AbilitySpectrum/Sensact/Enclosures/v4.2/Sensact v42 enclosure v1.3.stl

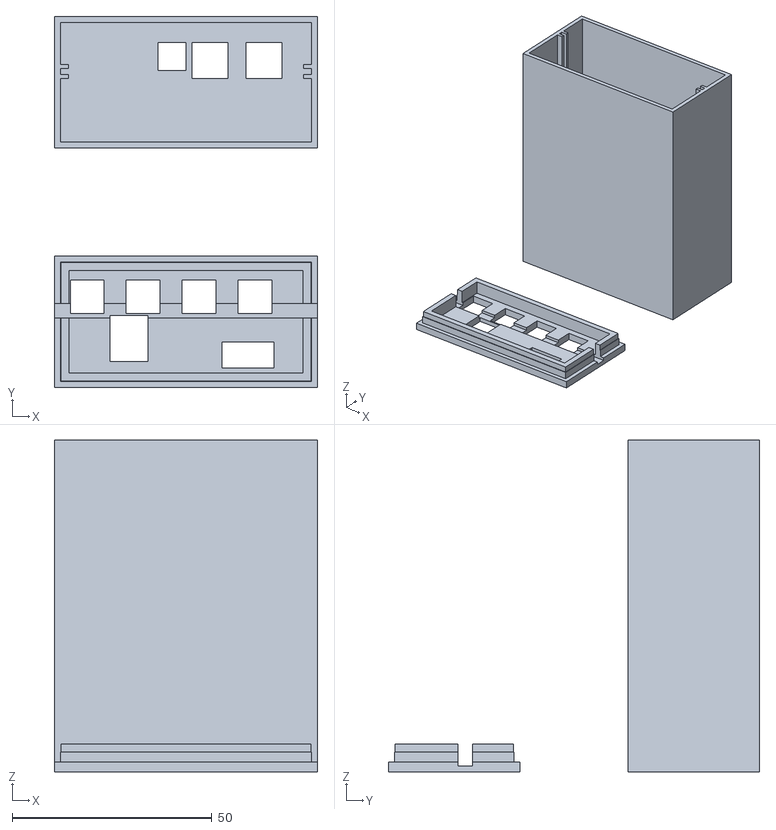
[picture p48: CAD file, 2018-05-30]
Enclosures/v4.2/Sensact v42 enclosure v1.3.stl
66.0 x 93.0 x 83.2
