AbilitySpectrum/Sensact/Arduino/Lib Instructions.txt

The Arduino code requires a version IRLib2 to compile and run.

We are using a version of IRLib2 by Chris Young - Version 2.0.16 May 3, 2018

To use this library: 
. Place the IRLib2-master.zip file in a separate directory
. Unzip the file
. Follow the installation instructions in the 'readme.md' file
