AbilitySpectrum/Sensact/Documents/ISAAC_2016_material/Roll_up_collage_low-1.pdf

# SENSACT

# The Applications

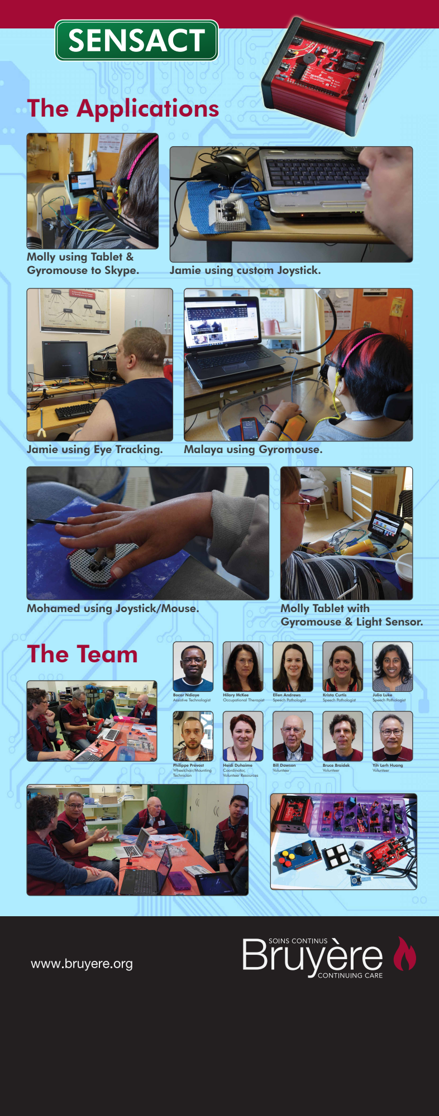
[picture p49: page 1]
The Team; Jamie using Eye Tracking.; Malaya using Gyromouse.; Mohamed using Joystick/Mouse.; Molly Tablet with; Bocar Ndiaye Assistive Technologist; Julia Luke Speech Pathologist; Heidi Duhaime Coordinator, Volunteer Resources; Bruce Braidek Volunteer; Bill Dawson Volunteer; Krista Curtis Speech Pathologist; Philippe Prévost Wheelchair/Mounting Technician; Hilary McKee Occupational Therapist; Ellen Andrews Speech Pathologist

Molly using Tablet &
Gyromouse to Skype.

Jamie using custom Joystick.

Gyromouse & Light Sensor.

Yih Lerh Huang
Volunteer
