AbilitySpectrum/Sensact/Documents/ISAAC_2016_material/SENSACT_FUNCTIONS_72x45-1.pdf

USER NEEDS | ACCESS METHODS | PROCESSOR | COMMUNICATION DEVICES

# SENSACT FUNCTIONS

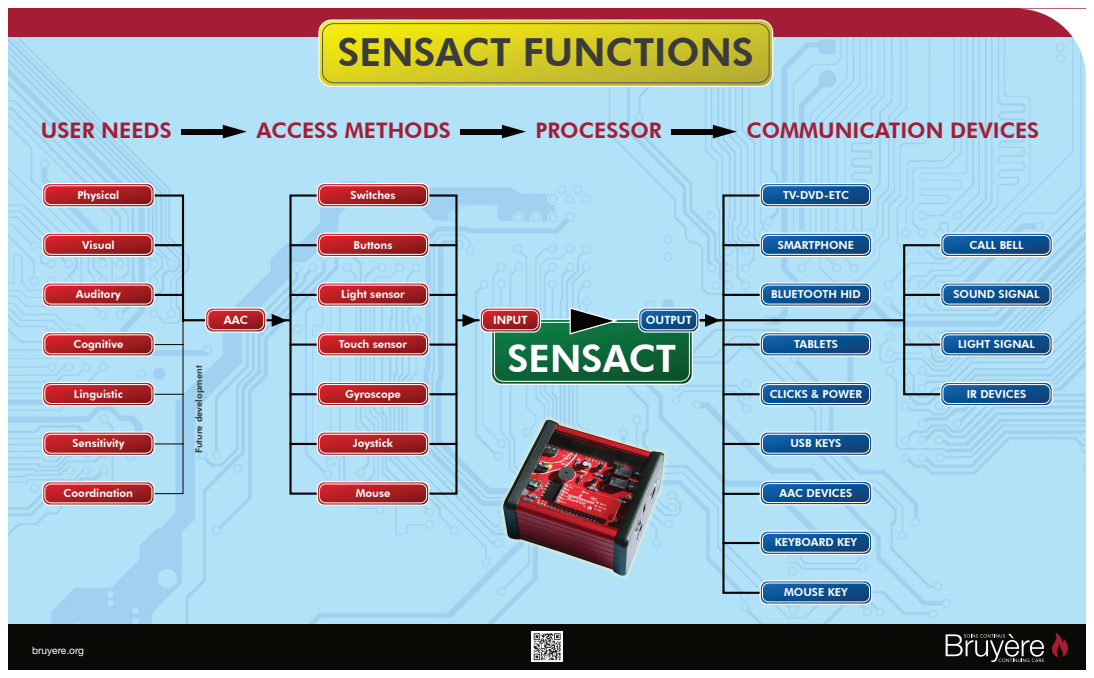
[picture p50: page 1]
bruyere.org; SENSACT; Physical; Visual; Auditory; Cognitive; Linguistic; Sensitivity; Coordination; Future development; Switches; Buttons; Light sensor; Touch sensor; Gyroscope; Joystick; Mouse; AAC; INPUT; OUTPUT; SMARTPHONE; BLUETOOTH HID; TABLETS; CLICKS & POWER; USB KEYS; AAC DEVICES; KEYBOARD KEY; MOUSE KEY; CALL BELL; SOUND SIGNAL; LIGHT SIGNAL; IR DEVICES

TV-DVD-ETC
