AbilitySpectrum/Sensact/Documents/ISAAC_2016_material/SENSACT_HARDWARE_72x36-1.pdf

## INPUT

## OUTPUT

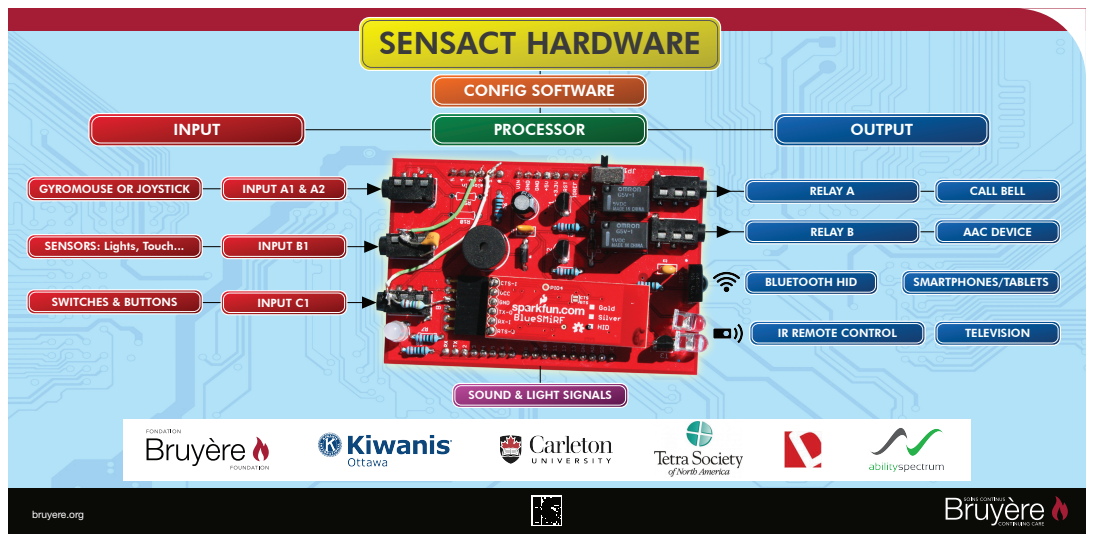
[picture p51: page 1]
bruyere.org; GYROMOUSE OR JOYSTICK; INPUT A1 & A2; RELAY A; CALL BELL; RELAY B; AAC DEVICE; IR REMOTE CONTROL; TELEVISION; SENSORS: Lights, Touch...; INPUT B1; SWITCHES & BUTTONS; INPUT C1; BLUETOOTH HID; SENSACT HARDWARE; PROCESSOR; CONFIG SOFTWARE; SMARTPHONES/TABLETS

SOUND & LIGHT SIGNALS
