AbilitySpectrum/Sensact/Board/v4.2/Schematic.pdf

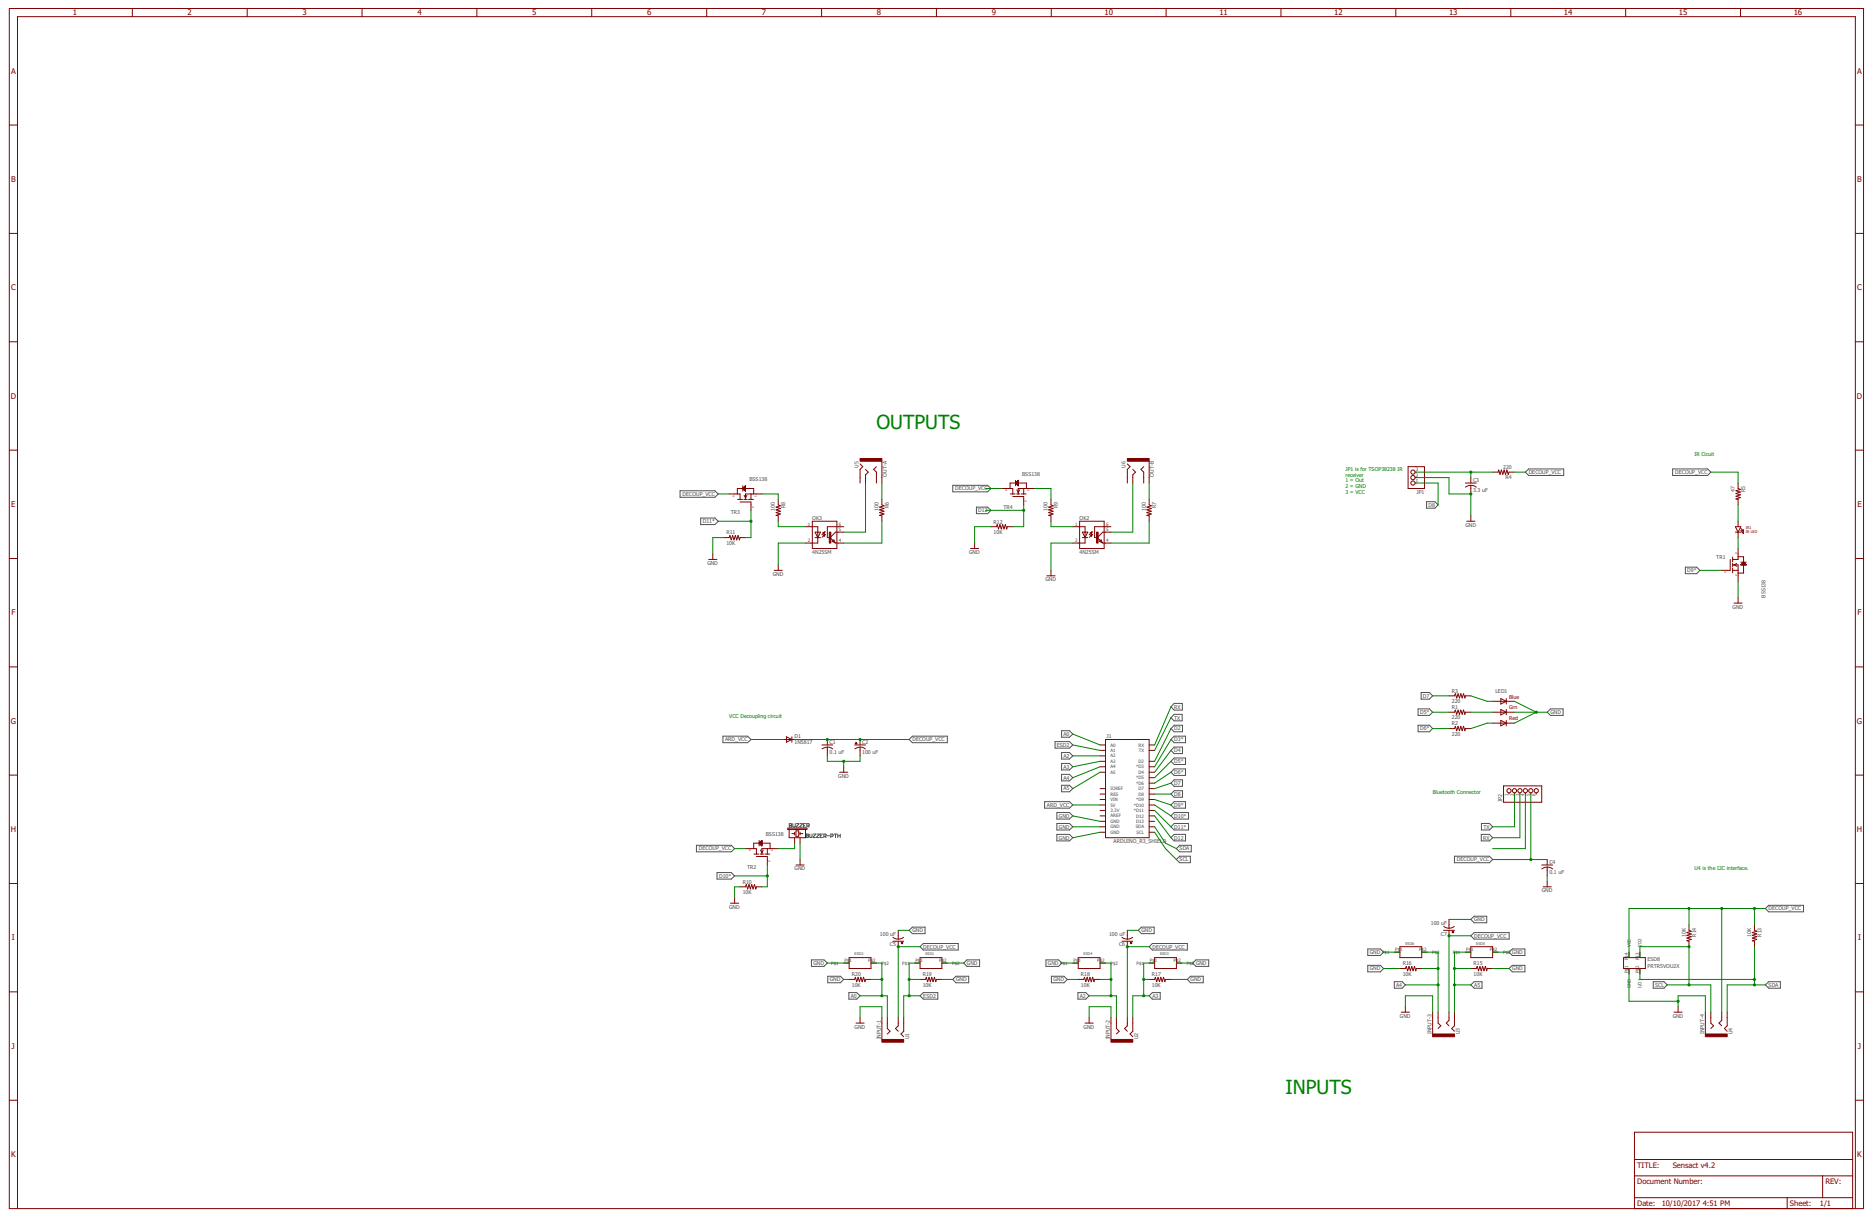
[picture p52: page 1]
