AbilitySpectrum/Sensact/Board/v4.2/4.2-Bottom.pdf

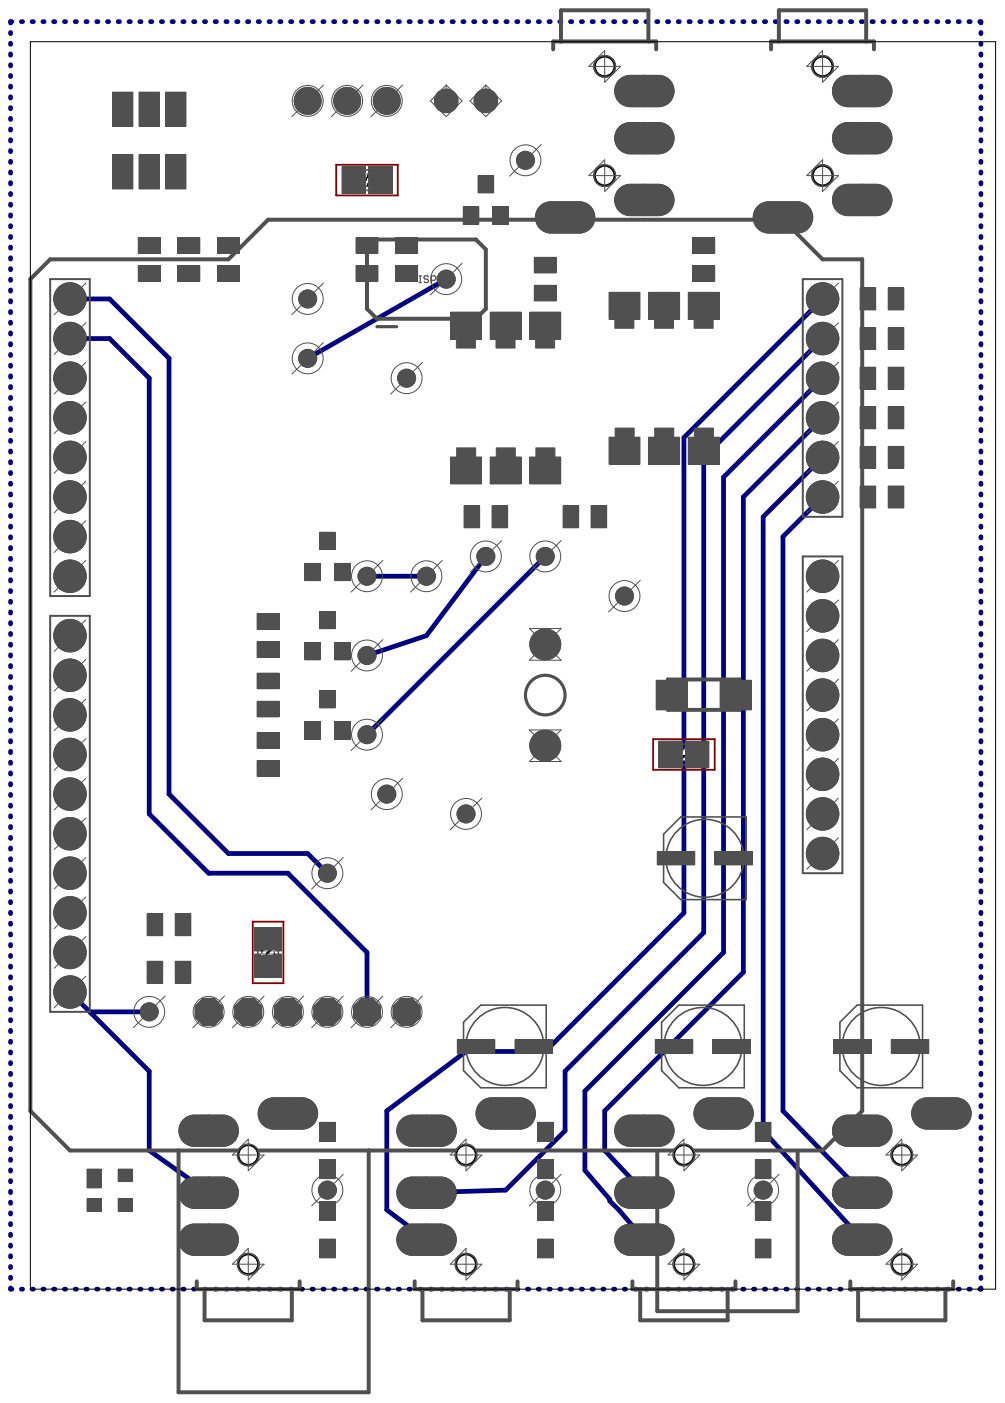
[picture p53: page 1]
