AbilitySpectrum/Sensact/Board/v4.2/4.2-Top.pdf

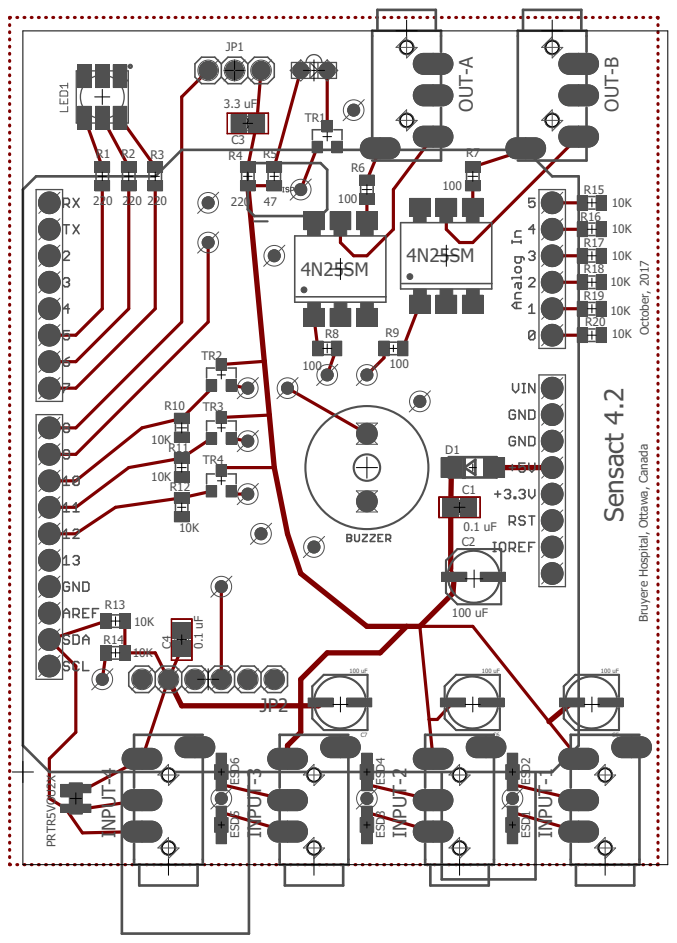
[picture p54: page 1]

Bruyere Hospital, Ottawa, Canada October, 2017
