AbilitySpectrum/Sensact/Board/v4.2/Sensact v4.2.brd

## EAGLE design Board/v4.2/Sensact v4.2.brd (2018-04-08)

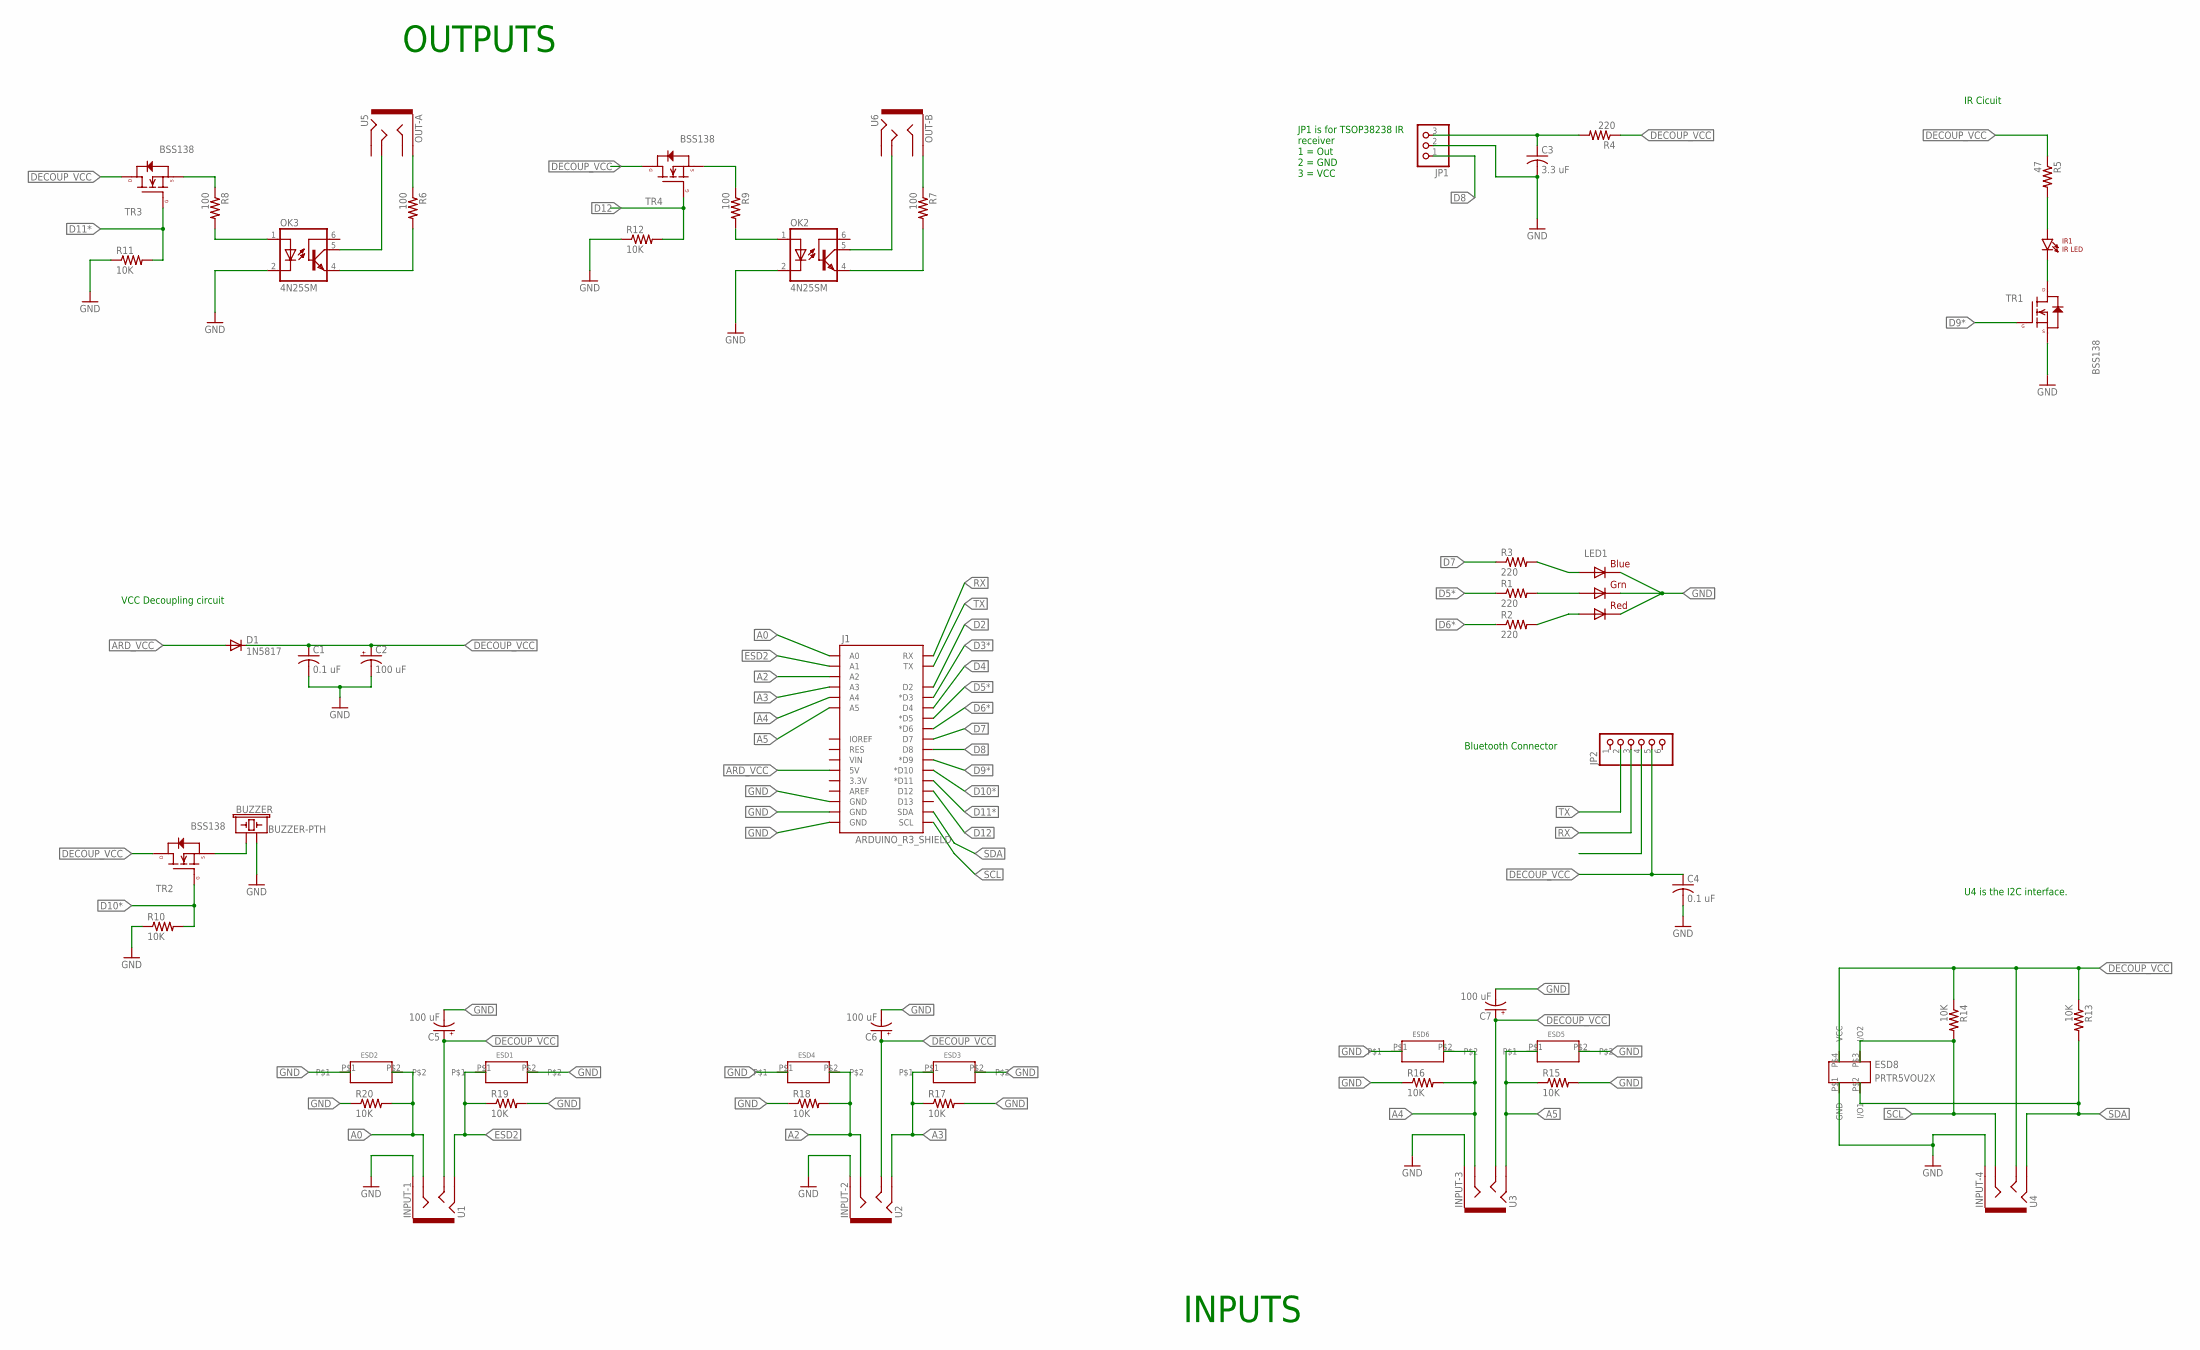
[picture p55: schematic Sensact v4.2.sch]

Parts:
BUZZER: BUZZER-PTH; BUZZER-12MM
C1, C4: 0.1 uF; C0805
C2, C5, C6, C7: 100 uF; PANASONIC_C
C3: 3.3 uF; C0805
D1: 1N5817; DO214AC
ESD1, ESD2, ESD3, ESD4, ESD5, ESD6: PESD5V0S1BA; SOD323
ESD8: PRTR5VOU2X; 215
INPUT-1: U1; AUDIO-JACK-TRRS-THRUHOLE
INPUT-2: U2; AUDIO-JACK-TRRS-THRUHOLE
INPUT-3: U3; AUDIO-JACK-TRRS-THRUHOLE
INPUT-4: U4; AUDIO-JACK-TRRS-THRUHOLE
IR1: IR LED; LTE-302
J1: ARDUINO_R3_SHIELD; UNO_R3_SHIELD
JP1: PINHD-1X3; 1X03
JP2: PINHD-1X6; 1X06
LED1: RGBLED5050
OK2, OK3: 4N25SM; DIL6-SMD
OUT-A: U5; AUDIO-JACK-TRRS-THRUHOLE
OUT-B: U6; AUDIO-JACK-TRRS-THRUHOLE
R1, R2, R3, R4: 220; 0805
R5: 47; 0805
R6, R7, R8, R9: 100; 0805
R10, R11, R12, R13, R14, R15, R16, R17, R18, R19, R20: 10K; 0805
TR1, TR2, TR3, TR4: BSS138; SOT23-3

Connections:
A0: ESD2.P$2, INPUT-1.RING1, J1.A0, R20.2
A2: ESD4.P$2, INPUT-2.RING1, J1.A2, R18.2
A3: ESD3.P$1, INPUT-2.RING2, J1.A3, R17.1
A4: ESD6.P$2, INPUT-3.RING1, J1.A4, R16.2
A5: ESD5.P$1, INPUT-3.RING2, J1.A5, R15.1
ARD_VCC: D1.A, J1.5V
D2: J1.D2
D3*: J1.D3 (*D3)
D4: J1.D4
D5*: J1.D5 (*D5), R1.1
D6*: J1.D6 (*D6), R2.1
D7: J1.D7, R3.1
D8: J1.D8, JP1.1
D9*: J1.D9 (*D9), TR1.1 (G)
D10*: J1.D10 (*D10), R10.2, TR2.1 (G)
D11*: J1.D11 (*D11), R11.2, TR3.1 (G)
D12: J1.D12, R12.2, TR4.1 (G)
DECOUP_VCC: C1.1, C2.+, C4.1, C5.+, C6.+, C7.+, D1.C, ESD8.P$4 (VCC), INPUT-1.TIP, INPUT-2.TIP, INPUT-3.TIP, INPUT-4.TIP, JP2.5, R4.1, R5.1, R13.1, R14.1, TR2.3 (D), TR3.3 (D), TR4.3 (D)
ESD2: ESD1.P$1, INPUT-1.RING2, J1.A1, R19.1
GND: BUZZER.- (2), C1.2, C2.-, C3.2, C4.2, ESD1.P$2, ESD2.P$1, ESD3.P$2, ESD4.P$1, ESD5.P$2, ESD6.P$1, ESD8.P$1 (GND), INPUT-1.SLEEVE (EARTH), INPUT-2.SLEEVE (EARTH), INPUT-3.SLEEVE (EARTH), INPUT-4.SLEEVE (EARTH), J1.GND@0 (GND), J1.GND@1 (GND), J1.GND@2 (GND), JP1.2, JP2.4, LED1.4 (BLUE_C), LED1.5 (RED_C), LED1.6 (GREEN_C), OK2.2 (C), OK3.2 (C), R10.1, R11.1, R12.1, R15.2, R16.1, R17.2, R18.1, R19.2, R20.1, TR1.2 (S)
unnamed: C3.1, JP1.3, R4.2
unnamed: OK3.4 (EMI), R6.2
unnamed: OK2.1 (A), R9.2
unnamed: OK3.1 (A), R8.2
unnamed: LED1.3 (BLUE_A), R3.2
unnamed: LED1.1 (GREEN_A), R1.2
unnamed: LED1.2 (RED_A), R2.2
unnamed: OK3.5 (COL), OUT-A.TIP
unnamed: OUT-A.SLEEVE (EARTH), R6.1
unnamed: OK2.5 (COL), OUT-B.TIP
unnamed: OUT-B.SLEEVE (EARTH), R7.1
unnamed: OK2.4 (EMI), R7.2
unnamed: IR1.A, R5.2
unnamed: IR1.C, TR1.3 (D)
unnamed: BUZZER.+ (1), TR2.2 (S)
unnamed: R9.1, TR4.2 (S)
unnamed: R8.1, TR3.2 (S)
RX: J1.RX, JP2.3
SCL: ESD8.P$3 (I/O2), INPUT-4.RING1, J1.SCL, R14.2
SDA: ESD8.P$2 (I/O1), INPUT-4.RING2, J1.SDA, R13.2
TX: J1.TX, JP2.2

Notes on the sheet:
JP1 is for TSOP38238 IR receiver 1 = Out 2 = GND 3 = VCC
VCC Decoupling circuit
U4 is the I2C interface.
OUTPUTS
INPUTS
Bluetooth Connector
IR Cicuit

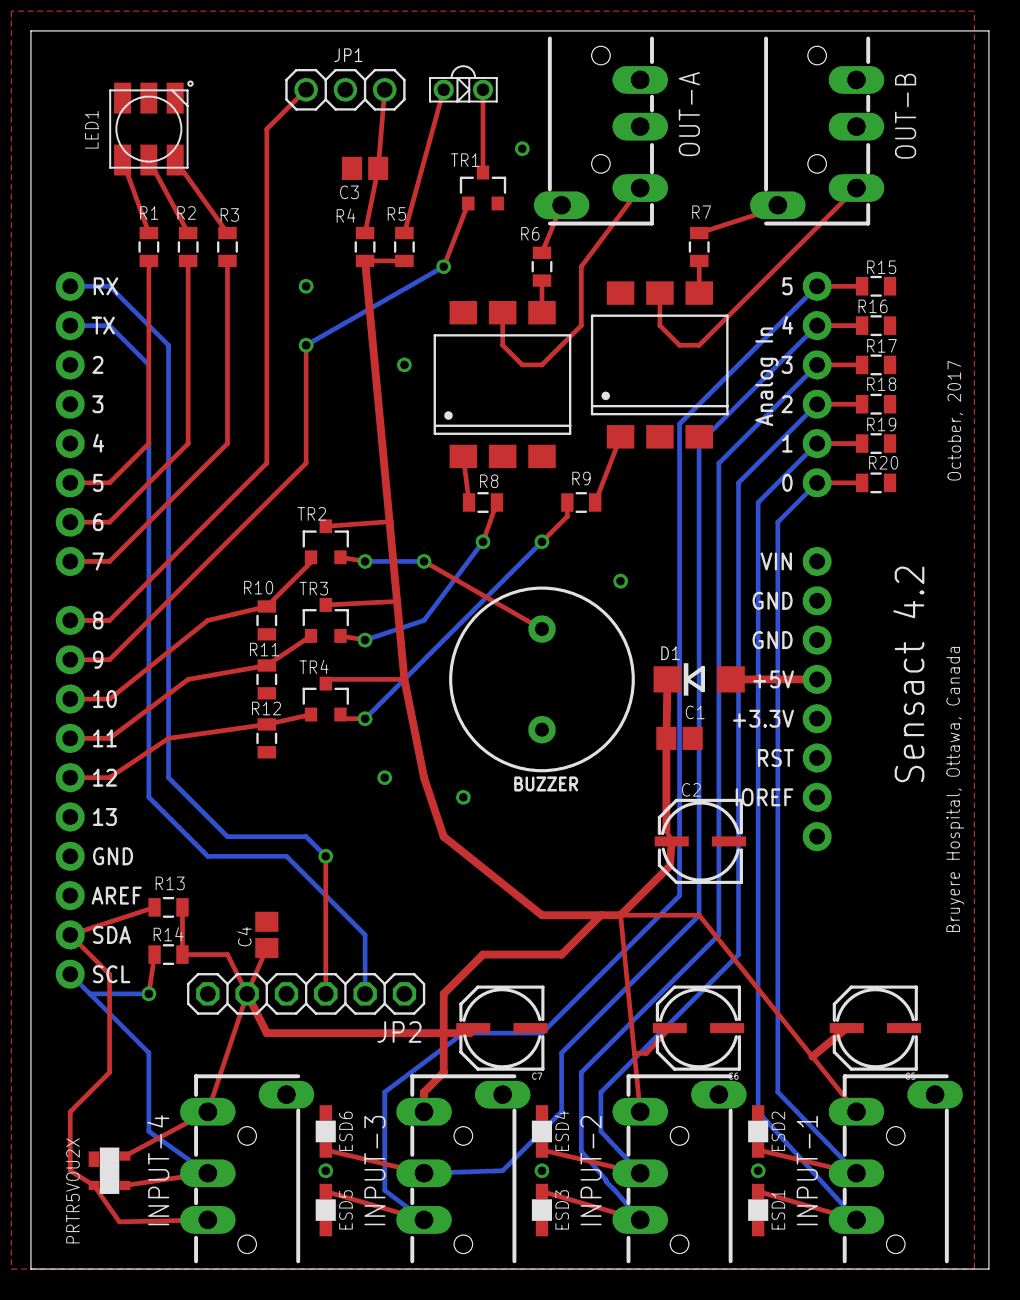
[picture p56: board Sensact v4.2.brd from above]

Board: 2 copper layers, 61.9 x 80.0 mm, 53 parts (0 on the bottom side), 38 nets.
