AbilitySpectrum/Sensact/Related_Projects/other/geninput/geninput.ino

#include <Mouse.h>
#include <Keyboard.h>

/*********************************************************
   2016-06-11 Sat : ylh

   I added reading from digital as well as analog lines and send the readings
   out to serial port (can be commented out in #define SERIAL_OUT

   digital signals are sent as -0, -1, etc
   analog signals are sent as "YPR:?:?:?"
   The touchpad signals are sent out as +0, +1, ..., +11

   These conventions are compatible with the p5 browser app:  ~/0/gendisplay

   HID mouse control is controlled from the Joystick's A0, A1 signals,
   click = digital pin 3 (LEFT) pin 2 (RIGHT)

   --- touch pad code comes from
   This is a library for the MPR121 12-channel Capacitive touch sensor

   Designed specifically to work with the MPR121 Breakout in the Adafruit shop
   ----> https://www.adafruit.com/products/

   These sensors use I2C communicate, at least 2 pins are required
   to interface

   Adafruit invests time and resources providing this open source code,
   please support Adafruit and open-source hardware by purchasing
   products from Adafruit!

   Written by Limor Fried/Ladyada for Adafruit Industries.
   BSD license, all text above must be included in any redistribution
 **********************************************************/
/*** HOW TO USE
   #define SERIAL_OUTPUT to output input signals. Do not use with mouse.
   #define SEE_ANALOG to output the analog pins
   #define SEE_DIGITAL to output the digital lines
   #define SEE_TOUCHPAD to output touchpad (I2C) data
   #define USE_MOUSE use mouse control - must turn off SERIAL_OUTPUT
*/
#define SERIAL_OUTPUT
#define SEE_ANALOG
#define SEE_DIGITAL
#define SEE_TOUCHPAD
//#define USE_MOUSE
//#define SEE_TOUCHPAD
//#define SPECIAL_MELANIE

const uint32_t CHECK_INTERVAL = 20;
const uint32_t REFRACTORY = 400;
uint32_t l_checked;

#include <Wire.h>
#include "Adafruit_MPR121.h"

// MPR touchpad
// You can have up to 4 on one i2c bus but one is enough for testing!
Adafruit_MPR121 cap = Adafruit_MPR121();
// output "+?" where ? is the key number

// Keeps track of the last pins touched
// so we know when buttons are 'released'
uint16_t lasttouched = 0;
uint16_t currtouched = 0;

// analogPins
const int nAnalogPins = 3;
int analogPins[nAnalogPins] = {
  A0, A1, A2
};

// digitalPins
// when pushed, we output "-0", "-1", "-2", "-3"
const int nDigitalPins = 8; //14;
int digitalPins[nDigitalPins] = {
  // 0, 1, 2, 3, 4, 5, 6, 7, 8, 9, 10, 11, 12, 13
  // 3, 4, 5, 6
  6, 7, 8, 9, A2, A3, A4, 0   // Emartee joystick+4 keys AND Sparkfun 4 pads: Melanie
};

int toggleLeft = 0; // for Drag
int keyPressed = 0;

void setup() {

#ifdef SERIAL_OUTPUT
  while (!Serial);        // needed to keep leonardo/micro from starting too fast!
  Serial.begin(9600);
#endif

#ifdef SEE_TOUCHPAD
  touchSetup();
#endif

#ifdef SEE_DIGITAL
  digitalPinsSetup();
#endif

#ifdef SEE_ANALOG
  analogPinsSetup();
#endif

#ifdef USE_MOUSE
  mouseSetup();
#endif
}

void loop() {

  if ( l_checked < CHECK_INTERVAL || l_checked < REFRACTORY ) l_checked = millis();

  if ( millis() - l_checked < CHECK_INTERVAL ) return;
  if ( keyPressed == 1 && ( millis() - l_checked < REFRACTORY ) ) return;
  keyPressed = 0;

  l_checked = millis();

#ifdef SEE_TOUCHPAD
  touchLoop();
#endif

#ifdef SEE_DIGITAL
  digitalPinsLoop();
#endif

#ifdef SEE_ANALOG
  analogPinsLoop();
#endif

#ifdef USE_MOUSE
  mouseLoop();
#endif

}

void analogPinsSetup() {
}

void analogPinsLoop() {

#ifdef SERIAL_OUTPUT
  Serial.print("YPR"); // use the YPR meter!

  for ( int j = 0; j < nAnalogPins; j++ ) {
    Serial.print(":");
    Serial.print(map(analogRead(analogPins[j]), 0, 1023, -60, 60 ));
  }
  Serial.print("\n");
#endif
}

void digitalPinsSetup() {
  for ( int j = 0; j < nDigitalPins; j++ ) {
    pinMode( digitalPins[j], INPUT_PULLUP);
  }
}

void digitalPinsLoop() {

  for ( int j = 0; j < nDigitalPins; j++ ) {
    if ( digitalRead(digitalPins[j]) == LOW ) {

#ifdef SERIAL_OUTPUT
      Serial.print("-:");
      Serial.println(j);
#endif

#ifdef SPECIAL_MELANIE
     melanieDown(j);
#endif
    }
    else {
#ifdef SPECIAL_MELANIE
      melanieUp(j);
#endif

    }
  }
}

#ifdef SPECIAL_MELANIE
void melanieDown( int j) {
  keyPressed = 1;
  if ( j == 0 ) {
    Keyboard.press(KEY_PAGE_DOWN);
  }
  if ( j == 3 ) {
    Mouse.press(MOUSE_LEFT);
    toggleLeft = 0;
  }
  if ( j == 2 ) {
    Keyboard.press(KEY_PAGE_UP);
  }
  if ( j == 1 ) {
    Mouse.press(MOUSE_RIGHT);
  }
  if ( j == 4 ) {
    if ( toggleLeft == 0 ) {
      Mouse.press(MOUSE_LEFT);
    }
    else  {
      Mouse.release(MOUSE_LEFT);
    }
    toggleLeft = 1 - toggleLeft;
  }
  if ( j == 5 ) {
    Keyboard.press('L');
    Keyboard.release('L');
    Keyboard.press('O');
    Keyboard.press('L');
    Keyboard.press('!');
    Keyboard.press(KEY_RETURN);
    Keyboard.releaseAll();
  }
  if ( j == 6 ) {
    Keyboard.press(KEY_ESC);
  }
  if ( j == 7 ) {
    Keyboard.press(KEY_LEFT_ALT);
    Keyboard.press(KEY_TAB);
  }
}


void melanieUp(int j) {
  if ( j == 0 ) {
    Keyboard.release(KEY_PAGE_DOWN);
  }
  if ( j == 3 ) {
    if ( toggleLeft == 0 ) {  // release Left Click only when NOT being dragged
      Mouse.release(MOUSE_LEFT);
    }
  }
  if ( j == 2 ) {
    Keyboard.release(KEY_PAGE_UP);
  }
  if ( j == 1 ) {
    Mouse.release(MOUSE_RIGHT);
  }
  if ( j == 4 ) {

  }
  if ( j == 5 ) {

  }
  if ( j == 6 ) {
    Keyboard.release(KEY_ESC);
  }
  if ( j == 7 ) {
    Keyboard.release(KEY_LEFT_ALT);
    Keyboard.release(KEY_TAB);
  }
}
#endif

#ifdef SEE_TOUCHPAD
void touchSetup() {

#ifdef SERIAL_OUTPUT
  Serial.println("Adafruit MPR121 Capacitive Touch sensor test");
#endif
  // Default address is 0x5A, if tied to 3.3V its 0x5B
  // If tied to SDA its 0x5C and if SCL then 0x5D
  if (!cap.begin(0x5A)) {

#ifdef SERIAL_OUTPUT
    Serial.println("MPR121 not found, check wiring ? ");
#endif
    while (1);
  }

#ifdef SERIAL_OUTPUT
  Serial.println("MPR121 found!");
#endif
}

void touchLoop() {
  // Get the currently touched pads
  currtouched = cap.touched();

  /* VERSION 1
    for (uint8_t i = 0; i < 12; i++) {
    // it if *is* touched and *wasnt* touched before, alert!
    if ((currtouched & _BV(i)) && !(lasttouched & _BV(i)) ) {
    Serial.print(" + : "); Serial.println(i); //Serial.println(" touched");
    }
    // if it *was* touched and now *isnt*, alert!
    if (!(currtouched & _BV(i)) && (lasttouched & _BV(i)) ) {
    Serial.print(" - : "); Serial.println(i); //Serial.println(" released");
    }
    }
    //*/

  //* VERSION to work with p5.js ~/0/touchpad
  for (uint8_t i = 0; i < 12; i++) {
    if ((currtouched & _BV(i)) ) {

#ifdef SERIAL_OUTPUT
      Serial.print("+:");
      Serial.println(i);
#endif
    }
  }

  //*/

  /* VERSION to output somewhat graphically
    for (uint8_t i = 0; i < 12; i++) {
    if ((currtouched & _BV(i)) ) {
    Serial.print(i);
    } else Serial.print(" ");
    }
    Serial.println();
    //*/

  // reset our state
  lasttouched = currtouched;

  // comment out this line for detailed data from the sensor!
  return;

  // debugging info, what
  Serial.print("\t\t\t\t\t\t\t\t\t\t\t\t\t 0x");
  Serial.println(cap.touched(), HEX);
  Serial.print("Filt : ");
  for (uint8_t i = 0; i < 12; i++) {
    Serial.print(cap.filteredData(i));
    Serial.print("\t");
  }
  Serial.println();
  Serial.print("Base : ");
  for (uint8_t i = 0; i < 12; i++) {
    Serial.print(cap.baselineData(i));
    Serial.print("\t");
  }
  Serial.println();

  // put a delay so it isn't overwhelming
  delay(500);
}

#endif
