AbilitySpectrum/Sensact/(commit log)

2016-03-28 Baseline code
    the Arduino version works with v1 of the Sensact board with the Pro
    Micro board
2016-04-11 modes for Sensact v2
    - local p5 files
    - #ifdefs for the two versions
    - remove gyro capabilities for now
2016-04-13 update
    - commented out gyro code
2016-05-07 - change index.html -> configSensact.html - added REFRACTORY period after trigger - bug fix: RELAY_? -> SENSACT_OUT?
2016-05-30 Initial commit of board design files
    These are the board design files for the board produced in April 2016.
    The Gerber files were placed in a subdirectory for simplicity.
    [DRILEGEND.CFG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]
2016-05-31 Added .pdf files of board and schematic
    Added .pdf files for those who don't use/have Eagle
2016-06-06 added functional doc, altered sensact arduino send config package
2016-06-07 minor update
    for newer Arduino IDE, say 1.6.3, we need to comment out
    - Mouse.h
    - HID.h
    - Keyboard.h
2016-06-17 Test program to be used following assembly
    This program tests the following functions:
    Beeper, Bluetooth, LED, and switch connected to D7
2016-06-21 changed mouse control
    - geninput: changed mouse control to use initial values for ‘zero’
    - sensact: now include output box
2016-06-21 added MPR121 enclosure
    [7cmx12cmX5cm.stl]
2016-06-23 arduino code can do multiple triggers per sensor. Also, can differentiate a long and short click.
    [SensactArduinoCode.ino]
2016-06-30 New Arduino code can now do buzzer, bluetooth HID, relays, keboard, and mouse. It is ready to be tested
    [SensactArduinoCode.ino]
2016-06-30 geninput handles joystick + 8 buttons for M.
2016-07-18 reset relays
2016-07-26 updated sensact app to display sensors over threshold range slider
2016-07-26 xbee bluetooth works as sensor
2016-07-27 long and short click function, can set long click time
    [SensactArduinoCode.ino]
2016-07-28 reorganized folders
    [7cmx12cmX5cm.stl, DRILEGEND.CFG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]
2016-07-28 added Enclosures/v1 and Documents/ISAAC_2016
    [sensact_box (2).stl, sensact_box (3).stl]
2016-07-28 short and long click work
    [SensactArduinoCode.ino]
2016-08-04 Config: fixed invert, changed some gui labels, port display now scrolls. \nArduino: fixed bluetooth communication errors, added mouse speed macro
    [SensactArduinoCode.ino]
2016-08-04 added bluno beetle code for Gyro Mouse
2016-08-06 Arduino code for BT_HID Sensact
2016-11-14 Create Sensact v3.0 schematic.pdf
2016-11-14 v3 board schematic added incorrectly, fixing...
2016-11-14 Adding v3 schematic for comment
2016-11-23 Version 3 Arduino Code
    Complete working code for Arduino side of version 3.
2016-11-27 Handle negative sensor values
    This change allows 2-byte values (in particular sensor values) to be
    negative numbers. Values in triggers and in sensor reports can now be
    negative.
2016-11-27 More IO adjustments.
    Corrections for negative number handling. Also add blank to the set of
    chars ignored as white space.
    [IO.cpp, IO.h, Triggers.cpp]
2016-12-02 "Keyboard" cmd from PC - Arduino side
    This was Bill's suggestion. Make it possible for a user who can control
    a PC, to send commands to the Sensact.
2016-12-02 "Keyboard" cmd from PC - PC side
    These files define a new web page with buttons. The page also uses
    serial.js.
2016-12-02 Committing Eagle files for Sensact 3.0a
    Board layout, schematic, and accompanying .pdfs. Also included Gerber
    files.
    [DRILEGEND.CFG, Sensact v3.0 a_backup.brd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]
2016-12-02 Display char value for PC Keyboard sensor.
    Use the character value, rather than character code in the Keyboard
    trigger. This is much easier for those customizing the function, since
    character values have to match those in keybdcontrol.html
2016-12-04 Gyro Sensor
    First cut of a gyro sensor. Now have IR and Gyro both. Code size is
    22,608 of 28,672. Increase max number of triggers and actions. Free
    heap space is now 592 bytes.
2017-01-15 Arduino 1.6.12 support
    Changes to support latest arduino version.
2017-01-15 Make mouse-button typing faster.
    Make mouse move faster as repeat action is continued.
2017-01-15 Show active sensors.
    Underline the text of sensors that have associated triggers.
2017-01-15 Change ANY trigger action.
    Do not trigger the ANY state trigger if sensor is already in the action
    state.
2017-01-22 UI Adjustments
    invert check box replaces active high/low radio btns.
    underline sensors which have triggers
    remove unused 'createSensorSelector' code
2017-03-02 Added Mouse Nudge
    Support for Gyro mouse control.
2017-04-17 Reset trigger states after a reload.
    This provides a way to recover from inadvertently getting a trigger into
    an unused (or possibly unknown) state.
    [Triggers.cpp]
2017-04-20 Enhancements to test program.
    Repeated reading of pins.
    Gyro I2C support.
2017-04-21 IR Testing
    Added 't' option for IR circuit testing.
2017-04-21 LED Correction
    Handle reverse logic for LEDs
    [SensactArduinoCode.ino]
2017-04-22 Us Pull ups on analog inputs
    Us pull up resistors so unconnected inputs do not float. This was also
    needed to make TASH switch work.
2017-04-22 Safety Reset
    When new triggers are loaded reset all triggers, actions and sensors.
    Unfortunately this consumed a bit of memory space and the max # of
    triggers has had to be reduced to 18.
    [Actions.cpp, Actions.h, Sensact.h, SensactArduinoCode.ino, Sensors.cpp, Sensors.h, Triggers.cpp, Triggers.h]
2017-04-26 Latch Logic Fix
    A previous change to deal with reverse LED logic also had the effect of
    turning off power to all the inputs - OOPS!
    [SensactArduinoCode.ino]
2017-05-10 Memory Saving Trick #2
    Put sensorID and actionID in char instead of int. Savings: 23 bytes.
2017-05-11 Dual trigger setting feedback.
    Trigger setting flashes a light AND sound the buzzer. Handy when we
    have no light.
    [SensactArduinoCode.ino]
2017-05-28 Keyboard Control classes
    Make keyboard control class structure similar to Mouse control. Also,
    fix a timing bug in the general repeat-action code.
    [Actions.cpp, Actions.h]
2017-05-29 Increase relay pulse width.
    This makes the call bell work.
2017-06-21 LED color correction
    Get the LED colors to display correctly.
    [Sensact.h, SensactArduinoCode.ino]
2017-08-18 SetState action support
    Allows one sensor to alter the state of another.
2017-09-05 Eagle & Gerber Files
    [Sensact v4.1.brd, Sensact v4.1.sch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]
2017-09-14 Arduino code update for V4.1
    Basic operation has been confirmed. Detailed testing should still be
    done.
2017-09-27 Bug Fix - 'Set State' action items not destroyed.
    Set action to ‘Set State’ – Sensor drop down appears. Go to another
    action. Sensor drop down does not disappear!!
2017-10-26 Stop runaway mouse repeat actions.
    If sensor value has been near 0 for 15 seconds assume it is
    disconnected.
2017-10-27 Gyro init improvement
    Initialize Gyro when it is plugged in. It can now be connected or
    disconnected at any time.
2017-10-28 Improved runaway mouse fix.
    Sensors are assumed DISCONNECTED until a non-zero signal is detected.
    This means no runaway mouse at all on startup.
    [SensactArduinoCode.ino, Triggers.cpp, Triggers.h]
2017-10-29 Runaway mouse #3
    Allow for negative values too - e.g. from gyro.
2017-11-07 Port Selection Dialog
    Add a port selection dialog for systems that do not provide a device
    with the name "Leonardo"
2018-01-08 Detect any gyro motion
    Use the sqrt of the sum of the squares of X, Y and Z gyro motions to
    detect any motion.
2018-01-24 Initial work on ATMega support.
    Not fully tested yet. Big issue - does not work with Bluetooth!! I2C
    is OK. IR is untested.
    [Actions.cpp, Actions.h, SensactArduinoCode.ino, Sensors.cpp]
2018-03-03 Lightbox
    A new feedback mechanism for clients - a box with controllable lights.
    Uses an MCP23008 to control 8 lights via the I2C port. Adjustments made
    to MAX_ACTIONS to squeeze into memory.
2018-03-05 Various UI adjustments
    Also, made ActionName an ENUM rather than just a String. Allows for
    more robust error checking.
    [SetThresholdsDlg.java]
2018-03-28 I18N Model resources
    Isolate sensor and action related strings to a resource file.
2018-03-29 Clear All & Active Tab Markers
    Add markers to show tabs which contain triggers, and add a button to
    clear all triggers from all tabs.
2018-04-04 Relay Options
    Relay ON and OFF options added.
2018-04-08 V4.2 board design
    [Sensact v4.2.brd, Sensact v4.2.sch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]
2018-05-22 Change INPUT to SENSOR
2018-05-23 Enclosure for v1.3 for Board release v4.2
    [Sensact v42 enclosure v1.3.stl]
2018-05-29 Key shortcuts for Run and Idle
    [MainFrame.java]
2018-05-30 Solutions Changes
    Major additions to the solutions button.
2018-05-30 New tones on Save
    Now success is signalled by two high beeps.
    Failure by a low raspberry.
    [SensactArduinoCode.ino]
2018-05-31 Added Schematic.pdf
2018-09-13 Init adjustment
    Initialize Trigger sensor state array right at the start.
2018-10-25 Minor test improvement
    Added more tones to buzzer test.
    [SensActTesting.ino]
2018-10-28 License header added to Arduino code
2018-12-03 Arduino changes
2019-04-09 Fix for IR code failures
    [MainFrame.java]
2019-05-13 New Serial Feedback program.
    [config.txt]
2019-05-15 Cut and Paste for Sensact Config
2019-05-15 More options for SerialFeedback
    Configurable display time and title bar.
    [config.txt]
2019-06-02 LED Display Code
    Supports Don's LED screen as a means to provide visual feedback.
2019-06-03 Minor bug fix.
    Sensor levels were not being copied correctly. Error was introduced
    when implementing copy/paste.
2019-06-07 LED_Display changed to LCD_Display
