AbilitySpectrum/Sensact/(notices)

Notices in the files:
Arduino/SensactArduinoCode/Triggers.h:
Sensact Arduino software is free software: you can redistribute it and/or modify
it under the terms of the GNU General Public License as published by
the Free Software Foundation, either version 3 of the License, or
(at your option) any later version.
parts and their libraries:
SparkFun-Boards: Licensing: Creative Commons ShareAlike 4.0 International - https://creativecommons.org/licenses/by-sa/4.0
